Olegas/smart-wipers/README.md

# smart-wipers
Умные дворники: автоматизируем автомобиль
https://habr.com/ru/company/tensor/blog/552726/
