Olegas/smart-wipers/board/smart-wipers-board/smart-wipers-board.kicad_pcb

## KiCad design board/smart-wipers-board/smart-wipers-board.kicad_pcb (2021-04-09)

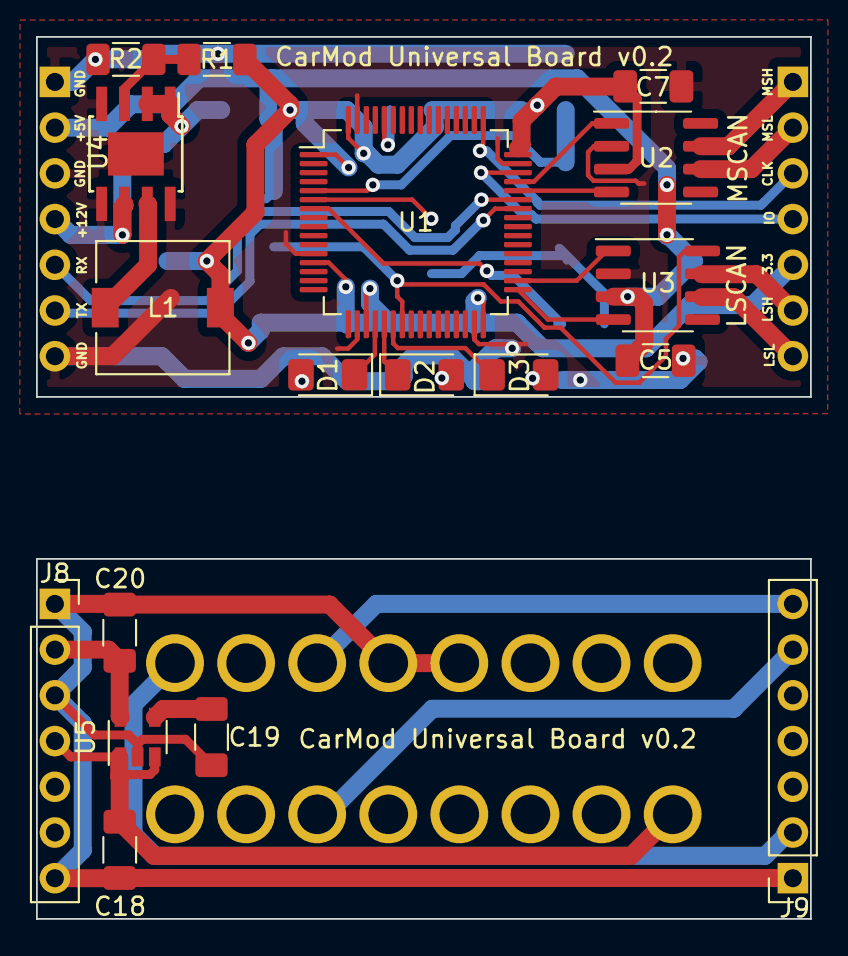
[picture p1: board smart-wipers-board.kicad_pcb from above]

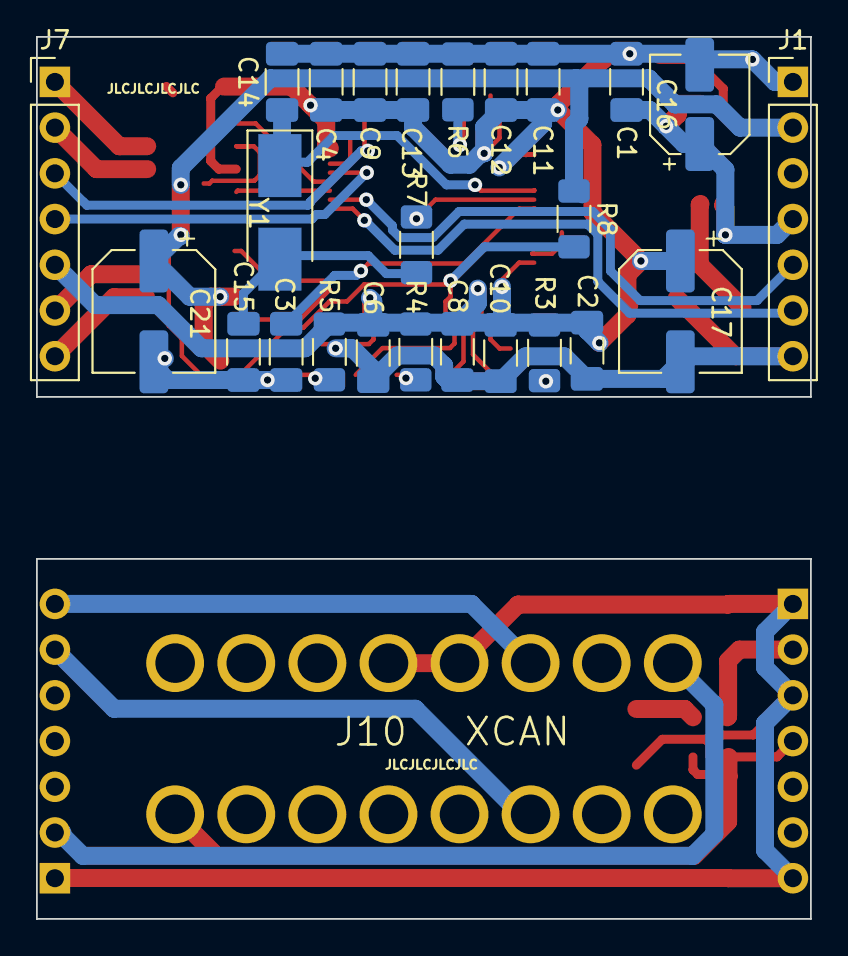
[picture p2: board smart-wipers-board.kicad_pcb from below]

Board: 2 copper layers, 43.0 x 20.0 mm, 44 parts (25 on the bottom side), 37 nets.

Parts:
C1, C2, C3, C4, C5, C6, C7, C8, C9, C10, C11: 100nF; C_1206_3216Metric_Pad1.33x1.80mm_HandSolder
C12, C18: 1uF; C_1206_3216Metric_Pad1.33x1.80mm_HandSolder
C13: 10uF; C_1206_3216Metric_Pad1.33x1.80mm_HandSolder
C14, C15: 15pF; C_1206_3216Metric_Pad1.33x1.80mm_HandSolder
C16: 10uF 25V; CP_Elec_5x5.7
C17, C21: 100uF 6.3V; CP_Elec_6.3x5.4
C19: 10nF; C_1206_3216Metric_Pad1.33x1.80mm_HandSolder
C20: 2.2uF; C_1206_3216Metric_Pad1.33x1.80mm_HandSolder
D1: LED_RED; LED_1206_3216Metric_Pad1.42x1.75mm_HandSolder
D2: LED_GREEN; LED_1206_3216Metric_Pad1.42x1.75mm_HandSolder
D3: LED_BLUE; LED_1206_3216Metric_Pad1.42x1.75mm_HandSolder
J1: X1; PinHeader_1x07_P2.54mm_Vertical
J7: X2; PinHeader_1x07_P2.54mm_Vertical
J8: XC1; PinSocket_1x07_P2.54mm_Vertical
J9: XC2; PinSocket_1x07_P2.54mm_Vertical
J10: XCAN; OBDII
L1: CDRH6D38NP-3R3NC; L_7.3x7.3_H3.5
R1: 16K; R_1206_3216Metric_Pad1.30x1.75mm_HandSolder
R2: 5.1K; R_1206_3216Metric_Pad1.30x1.75mm_HandSolder
R3: 56; R_1206_3216Metric_Pad1.30x1.75mm_HandSolder
R4, R5, R8: 15; R_1206_3216Metric_Pad1.30x1.75mm_HandSolder
R6: 10K; R_1206_3216Metric_Pad1.30x1.75mm_HandSolder
R7: 390; R_1206_3216Metric_Pad1.30x1.75mm_HandSolder
U1: STM32F105R8Tx; LQFP-64_10x10mm_P0.5mm
U2: SN65HVD232; SOIC-8_3.9x4.9mm_P1.27mm
U3: MCP2551-I-SN; SOIC-8_3.9x4.9mm_P1.27mm
U4: ST1S10PHR; TI_SO-PowerPAD-8
U5: LP2985-5.0; SOT-23-5
Y1: 8Mhz; Crystal_SMD_5032-2Pin_5.0x3.2mm_HandSoldering

Connections:
+5V: C5.1, C21.1, J1.2, R8.1, U3.3
+12V: C1.1, C16.1, J1.4, U4.1, U4.2, U4.6
/FB: R1.2, R2.1, U4.3
BOOT0: R6.1, U1.60
CAN_5v: C20.1, J8.2, U5.5
CAN_12v: C18.1, J8.4, J10.16, U5.1, U5.3
CAN_GND: C18.2, C19.2, C20.2, J8.1, J8.3, J8.7, J9.1, J10.4, J10.5, U5.2
CAN_LSH: J9.2, J10.1
CAN_MSH: J9.7, J10.3
CAN_MSL: J9.6, J10.11
GNDREF: C1.2, C2.2, C3.2, C4.2, C5.2, C6.2, C7.2, C8.2, C9.2, C10.2, C11.2, C12.2, C13.2, C14.2, C15.2, C16.2, C17.2, C21.2, J1.1, J1.3, J1.7, R2.2, R6.2, U1.12, U1.18, U1.31, U1.47, U1.63, U2.2, U3.2, U4.4, U4.5, U4.8, U4.9
LED_ACC: D2.1, U1.21
LED_BOOT: D1.1, U1.20
LED_LOWT: D3.1, U1.22
LSCANH: J7.6, U3.7
LSCANL: J7.7, U3.6
LSCAN_RX: U1.33, U3.4
LSCAN_TX: U1.34, U3.1
LS_CONTROL: R8.2, U1.23, U3.8
MSCANH: J7.1, U2.7
MSCANL: J7.2, U2.6
MSCAN_RX: U1.44, U2.4
MSCAN_TX: U1.45, U2.1
unnamed: C15.1, R7.2, Y1.2
unnamed: C19.1, U5.4
unnamed: D1.2, R3.2
unnamed: D2.2, R4.2
unnamed: D3.2, R5.2
unnamed: L1.1, U4.7
OSC_IN: C14.1, U1.5, Y1.1
OSC_OUT: R7.1, U1.6
RESET: C3.1, U1.7
SWCLK: J7.3, U1.49
SWDIO: J7.4, U1.46
UART_RX: J1.5, U1.43
UART_TX: J1.6, U1.42
VDD: C2.1, C4.1, C6.1, C7.1, C8.1, C9.1, C10.1, C11.1, C12.1, C13.1, C17.1, J7.5, L1.2, R1.1, R3.1, R4.1, R5.1, U1.1, U1.13, U1.19, U1.32, U1.48, U1.64, U2.3
