Olegas/smart-wipers/Core/Src/main.c

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
/* Includes ------------------------------------------------------------------*/
#include "main.h"
#include "can.h"
#include "tim.h"
#include "usart.h"
#include "gpio.h"

/* USER CODE BEGIN Includes */
#include "vehicle_wipers.h"
#include "vehicle_util.h"
#include <string.h>
/* USER CODE END Includes */


/* USER CODE BEGIN PV */
char *banner = "\n\n\nCarMod "
    VERSION
    " ready\nBuild date: "
    __DATE__
    "\n\n";
/* USER CODE END PV */

void SystemClock_Config(void);
/**
  * @brief  The application entry point.
  * @retval int
  */
int main(void)
{
  /* MCU Configuration--------------------------------------------------------*/

  /* Reset of all peripherals, Initializes the Flash interface and the Systick. */
  HAL_Init();

  /* Configure the system clock */
  SystemClock_Config();

  /* Initialize all configured peripherals */
  MX_GPIO_Init();
  MX_CAN1_Init();
  MX_CAN2_Init();
  MX_USART1_UART_Init();
  MX_TIM2_Init();
  /* USER CODE BEGIN 2 */
  HAL_GPIO_WritePin(LED_BOOT_GPIO_Port, LED_BOOT_Pin, GPIO_PIN_RESET);
#ifdef DEBUG_REPORT_VEHICLE_STATE
  HAL_UART_Transmit(&huart1, (uint8_t *)banner, strlen(banner), 100);
  HAL_TIM_Base_Start_IT(&htim2);
#endif
  CAN_Init_Filter();
  /* USER CODE END 2 */

  /* Infinite loop */
  /* USER CODE BEGIN WHILE */
  while (1)
  {
    park_wipers_if_needed();
    /* USER CODE END WHILE */

    /* USER CODE BEGIN 3 */
  }
  /* USER CODE END 3 */
}

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
