Olegas/smart-wipers/smart-wipers.ioc

Mcu.UserName=STM32F105R8Tx
PA6.GPIO_Label=LED_LOWT
PB13.Signal=CAN2_TX
PD1-OSC_OUT.Signal=RCC_OSC_OUT
PA12.Signal=CAN1_TX
PA6.Signal=GPIO_Output
PA10.Signal=USART1_RX
PA4.GPIO_Label=LED_BOOT
PD0-OSC_IN.Signal=RCC_OSC_IN
PA13.Signal=SYS_JTMS-SWDIO
PA9.Signal=USART1_TX
PA5.Signal=GPIO_Output
PA4.Signal=GPIO_Output
PA7.GPIO_Label=SLOPE_CTL
PA5.GPIO_Label=LED_ACC
PA11.Signal=CAN1_RX
PA14.Signal=SYS_JTCK-SWCLK
PB12.Signal=CAN2_RX
PA7.Signal=GPIO_Output
