Olegas/smart-wipers/Core/Inc/main.h

#define LED_BOOT_Pin GPIO_PIN_4
#define LED_BOOT_GPIO_Port GPIOA
#define LED_ACC_Pin GPIO_PIN_5
#define LED_ACC_GPIO_Port GPIOA
#define LED_LOWT_Pin GPIO_PIN_6
#define LED_LOWT_GPIO_Port GPIOA
#define SLOPE_CTL_Pin GPIO_PIN_7
#define SLOPE_CTL_GPIO_Port GPIOA
