Olegas/smart-wipers/Core/Inc/vehicle_state.h

//
// Created by Oleg Elifantiev on 14.02.2021.
//

#ifndef SMART_WIPERS_VEHICLE_STATE_H
#define SMART_WIPERS_VEHICLE_STATE_H

#include "main.h"

#define TEMP_MSG_ID (0x350)
#define COLUMN_SWITCHES_MSG_ID (0x175)
#define MOTION_MSG_ID (0x108)

#define ENGINE_STATUS_UNKNOWN (255)
#define ENGINE_STATUS_RUNNING (2)
#define ENGINE_STATUS_OFF (0)

void update_current_temp(double new_temp);
void update_engine_status(uint8_t new_status);
void react_on_steering_wheel_switches(uint8_t const *data);
void beep(uint8_t wait, uint8_t count, uint8_t length);

#endif //SMART_WIPERS_VEHICLE_STATE_H
