Olegas/smart-wipers/Core/Src/can.c

/**
  ******************************************************************************
  * @file    can.c
  * @brief   This file provides code for the configuration
  *          of the CAN instances.
  ******************************************************************************
  * @attention
  *
  * <h2><center>&copy; Copyright (c) 2021 STMicroelectronics.
  * All rights reserved.</center></h2>
  *
  * This software component is licensed by ST under BSD 3-Clause license,
  * the "License"; You may not use this file except in compliance with the
  * License. You may obtain a copy of the License at:
  *                        opensource.org/licenses/BSD-3-Clause
  *
  ******************************************************************************
  */

/* Includes ------------------------------------------------------------------*/
#include "can.h"

/* USER CODE BEGIN 0 */
#include "usart.h"
#include "vehicle_state.h"
#include <stdio.h>
#include <string.h>

/* USER CODE END 0 */

CAN_HandleTypeDef hcan1;
CAN_HandleTypeDef hcan2;

/* CAN1 init function */
void MX_CAN1_Init(void)
{

  hcan1.Instance = CAN1;
  hcan1.Init.Prescaler = 6;
  hcan1.Init.Mode = CAN_MODE_SILENT;
  hcan1.Init.SyncJumpWidth = CAN_SJW_4TQ;
  hcan1.Init.TimeSeg1 = CAN_BS1_10TQ;
  hcan1.Init.TimeSeg2 = CAN_BS2_3TQ;
  hcan1.Init.TimeTriggeredMode = DISABLE;
  hcan1.Init.AutoBusOff = DISABLE;
  hcan1.Init.AutoWakeUp = DISABLE;
  hcan1.Init.AutoRetransmission = DISABLE;
  hcan1.Init.ReceiveFifoLocked = DISABLE;
  hcan1.Init.TransmitFifoPriority = DISABLE;
  if (HAL_CAN_Init(&hcan1) != HAL_OK)
  {
    Error_Handler();
  }

}
/* CAN2 init function */
void MX_CAN2_Init(void)
{

  hcan2.Instance = CAN2;
  hcan2.Init.Prescaler = 15;
  hcan2.Init.Mode = CAN_MODE_NORMAL;
  hcan2.Init.SyncJumpWidth = CAN_SJW_4TQ;
  hcan2.Init.TimeSeg1 = CAN_BS1_13TQ;
  hcan2.Init.TimeSeg2 = CAN_BS2_2TQ;
  hcan2.Init.TimeTriggeredMode = DISABLE;
  hcan2.Init.AutoBusOff = DISABLE;
  hcan2.Init.AutoWakeUp = DISABLE;
  hcan2.Init.AutoRetransmission = DISABLE;
  hcan2.Init.ReceiveFifoLocked = DISABLE;
  hcan2.Init.TransmitFifoPriority = DISABLE;
  if (HAL_CAN_Init(&hcan2) != HAL_OK)
  {
    Error_Handler();
  }

}

static uint32_t HAL_RCC_CAN1_CLK_ENABLED=0;

void HAL_CAN_MspInit(CAN_HandleTypeDef* canHandle)
{

  GPIO_InitTypeDef GPIO_InitStruct = {0};
  if(canHandle->Instance==CAN1)
  {
    /* CAN1 clock enable */
    HAL_RCC_CAN1_CLK_ENABLED++;
    if(HAL_RCC_CAN1_CLK_ENABLED==1){
      __HAL_RCC_CAN1_CLK_ENABLE();
    }

    __HAL_RCC_GPIOA_CLK_ENABLE();
    /**CAN1 GPIO Configuration
    PA11     ------> CAN1_RX
    PA12     ------> CAN1_TX
    */
    GPIO_InitStruct.Pin = GPIO_PIN_11;
    GPIO_InitStruct.Mode = GPIO_MODE_INPUT;
    GPIO_InitStruct.Pull = GPIO_NOPULL;
    HAL_GPIO_Init(GPIOA, &GPIO_InitStruct);

    GPIO_InitStruct.Pin = GPIO_PIN_12;
    GPIO_InitStruct.Mode = GPIO_MODE_AF_PP;
    GPIO_InitStruct.Speed = GPIO_SPEED_FREQ_HIGH;
    HAL_GPIO_Init(GPIOA, &GPIO_InitStruct);

    /* CAN1 interrupt Init */
    HAL_NVIC_SetPriority(CAN1_RX0_IRQn, 0, 0);
    HAL_NVIC_EnableIRQ(CAN1_RX0_IRQn);
  }
  else if(canHandle->Instance==CAN2)
  {
    /* CAN2 clock enable */
    __HAL_RCC_CAN2_CLK_ENABLE();
    HAL_RCC_CAN1_CLK_ENABLED++;
    if(HAL_RCC_CAN1_CLK_ENABLED==1){
      __HAL_RCC_CAN1_CLK_ENABLE();
    }

    __HAL_RCC_GPIOB_CLK_ENABLE();
    /**CAN2 GPIO Configuration
    PB12     ------> CAN2_RX
    PB13     ------> CAN2_TX
    */
    GPIO_InitStruct.Pin = GPIO_PIN_12;
    GPIO_InitStruct.Mode = GPIO_MODE_INPUT;
    GPIO_InitStruct.Pull = GPIO_NOPULL;
    HAL_GPIO_Init(GPIOB, &GPIO_InitStruct);

    GPIO_InitStruct.Pin = GPIO_PIN_13;
    GPIO_InitStruct.Mode = GPIO_MODE_AF_PP;
    GPIO_InitStruct.Speed = GPIO_SPEED_FREQ_HIGH;
    HAL_GPIO_Init(GPIOB, &GPIO_InitStruct);

    /* CAN2 interrupt Init */
    HAL_NVIC_SetPriority(CAN2_RX0_IRQn, 0, 0);
    HAL_NVIC_EnableIRQ(CAN2_RX0_IRQn);
  }
}

void HAL_CAN_MspDeInit(CAN_HandleTypeDef* canHandle)
{

  if(canHandle->Instance==CAN1)
  {
    /* Peripheral clock disable */
    HAL_RCC_CAN1_CLK_ENABLED--;
    if(HAL_RCC_CAN1_CLK_ENABLED==0){
      __HAL_RCC_CAN1_CLK_DISABLE();
    }

    /**CAN1 GPIO Configuration
    PA11     ------> CAN1_RX
    PA12     ------> CAN1_TX
    */
    HAL_GPIO_DeInit(GPIOA, GPIO_PIN_11|GPIO_PIN_12);

    /* CAN1 interrupt Deinit */
    HAL_NVIC_DisableIRQ(CAN1_RX0_IRQn);
  }
  else if(canHandle->Instance==CAN2)
  {
    /* Peripheral clock disable */
    __HAL_RCC_CAN2_CLK_DISABLE();
    HAL_RCC_CAN1_CLK_ENABLED--;
    if(HAL_RCC_CAN1_CLK_ENABLED==0){
      __HAL_RCC_CAN1_CLK_DISABLE();
    }

    /**CAN2 GPIO Configuration
    PB12     ------> CAN2_RX
    PB13     ------> CAN2_TX
    */
    HAL_GPIO_DeInit(GPIOB, GPIO_PIN_12|GPIO_PIN_13);

    /* CAN2 interrupt Deinit */
    HAL_NVIC_DisableIRQ(CAN2_RX0_IRQn);
  }
}

/* USER CODE BEGIN 1 */
void CAN_Error_Handler() {
  Error_Handler();
}

void CAN_Init_Filter() {
  CAN_FilterTypeDef filter;

  filter.FilterBank = 0;
  filter.FilterMode = CAN_FILTERMODE_IDLIST;
  filter.FilterScale = CAN_FILTERSCALE_16BIT;
  filter.FilterIdLow = TEMP_MSG_ID << 5;
  filter.FilterMaskIdLow = MOTION_MSG_ID << 5;
  filter.FilterIdHigh = COLUMN_SWITCHES_MSG_ID << 5;
  filter.FilterMaskIdHigh = 0x00;
  filter.FilterFIFOAssignment = CAN_RX_FIFO0;
  filter.FilterActivation = ENABLE;

  if (HAL_CAN_ConfigFilter(&LSCAN, &filter) != HAL_OK) {
    CAN_Error_Handler();
  }

  if (HAL_CAN_Start(&LSCAN) != HAL_OK) {
    CAN_Error_Handler();
  }

  if (HAL_CAN_ActivateNotification(&LSCAN, CAN_IT_RX_FIFO0_MSG_PENDING) != HAL_OK) {
    CAN_Error_Handler();
  }

  if (HAL_CAN_Start(&MSCAN) != HAL_OK) {
    CAN_Error_Handler();
  }
}

uint8_t engine_status_from_can(uint8_t const *data) {
  if (data[0] > 0x10) {
    return ENGINE_STATUS_RUNNING;
  }
  return ENGINE_STATUS_OFF;
}

void report_packet(CAN_RxHeaderTypeDef header, uint8_t data[8]) {
  char buffer[255];
  sprintf(buffer,
          "%03lX: %02X %02X %02X %02X %02X %02X %02X %02X\n",
          header.StdId,
          data[0], data[1], data[2], data[3], data[4], data[5], data[6], data[7]);
  HAL_UART_Transmit(&huart1, (uint8_t *) buffer, strlen(buffer), 100);
}

void HAL_CAN_RxFifo0MsgPendingCallback(CAN_HandleTypeDef *hCAN) {
  CAN_RxHeaderTypeDef header;
  uint8_t data[8];

  if (HAL_CAN_GetRxMessage(hCAN, CAN_RX_FIFO0, &header, data) != HAL_OK) {
    CAN_Error_Handler();
  }

  if (header.StdId == MOTION_MSG_ID) {
#ifdef DEBUG_REPORT_MOTION
    report_packet(header, data);
#endif
    update_engine_status(engine_status_from_can(data));
  } else if (header.StdId == TEMP_MSG_ID) {
    update_current_temp(((((data[1] & 0x03) << 8) + data[2]) / 8.0) - 40.0);
  } else if (header.StdId == COLUMN_SWITCHES_MSG_ID) {
#ifdef DEBUG_REPORT_STEERING_SWITCHES
    report_packet(header, data);
#endif
    react_on_steering_wheel_switches(data);
  }
}


void LSCAN_SendData(uint32_t id, uint8_t *data, uint8_t len) {
  uint32_t mbox;
  CAN_TxHeaderTypeDef header;
  if (HAL_CAN_GetTxMailboxesFreeLevel(&LSCAN) != 0) {
    header.StdId = id;
    header.IDE = CAN_ID_STD;
    header.DLC = len;
    header.RTR = CAN_RTR_DATA;
    header.TransmitGlobalTime = DISABLE;
    HAL_StatusTypeDef status = HAL_CAN_AddTxMessage(&LSCAN, &header, data, &mbox);
    if (status != HAL_OK) {
      Error_Handler();
    }
  } else {
    Error_Handler();
  }
}
/* USER CODE END 1 */

/************************ (C) COPYRIGHT STMicroelectronics *****END OF FILE****/
