Olegas/smart-wipers/Core/Inc/vehicle_wipers.h

//
// Created by Oleg Elifantiev on 28.02.2021.
//

#ifndef SMART_WIPERS_VEHICLE_WIPERS_H
#define SMART_WIPERS_VEHICLE_WIPERS_H

void park_wipers_if_needed();
void request_park();
#endif //SMART_WIPERS_VEHICLE_WIPERS_H
