Olegas/smart-wipers/Core/Inc/vehicle_util.h

//
// Created by Oleg Elifantiev on 28.02.2021.
//

#ifndef SMART_WIPERS_VEHICLE_UTIL_H
#define SMART_WIPERS_VEHICLE_UTIL_H

#include "main.h"

void beep(uint8_t wait, uint8_t count, uint8_t length);

#endif //SMART_WIPERS_VEHICLE_UTIL_H
