Olegas/smart-wipers/(commit log)

2021-01-21 Board v1
    [smart-wipers-board.kicad_pcb, smart-wipers-board.sch]
2021-02-14 WIP Компилируется
    [stm32f3discovery.cfg]
2021-02-14 WIP Разнес периферию по файлам
2021-02-14 WIP Переименовал проект
2021-02-23 WIP Board design
    [smart-wipers-board.kicad_pcb, smart-wipers-board.sch]
2021-02-27 CAN buses swapped because of wrong design of v0.1 board CAN speed configuration adjusted
    [can.c, smart-wipers.ioc]
2021-03-07 WIP Board v0.2 design
    [smart-wipers-board.kicad_pcb, smart-wipers-board.sch]
2021-04-09 Code for v0.2 layout
    [smart-wipers-board.kicad_pcb]
2021-04-09 Board fixes
    [smart-wipers-board.kicad_pcb, smart-wipers-board.sch]
2021-04-10 Правильная конфигурация шины, срабатываем при 20 градусах для демонстрации
2021-04-10 Одно махание дворниками не триггерит парковку
2021-11-18 Понизил частоту чипа до 8Mhz, убрал TIM1 - не использовался
